DSHubicom/24-25-proyectos-finales-carolina-daniel/Documentacion/Esquemas_de_montaje/Receptor.png

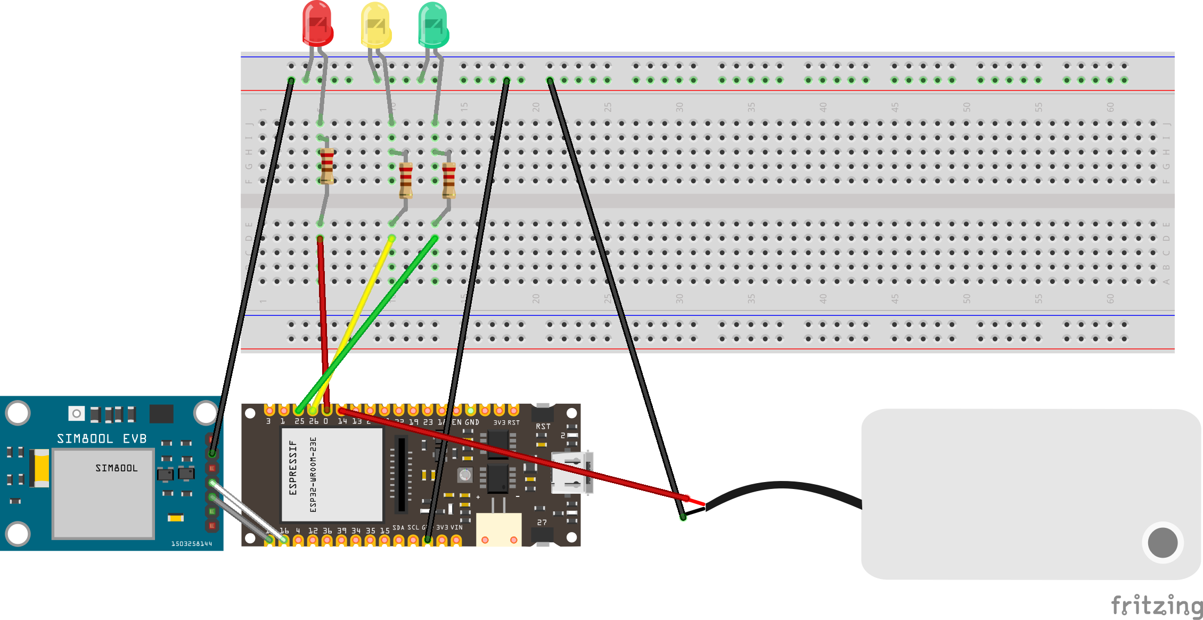
Documentacion/Esquemas_de_montaje/Receptor.png
